Danjovic/VGA_Blinken/Readme.md

# VGA Blinking Lights
This project consists of a a device capable of generating a (pseudo) random blinking lights pattern. The objective of this project is to turn old monitors, specially CRTs, into decorative objects.
