Danjovic/VGA_Blinken/circuit/VGA Blinken.brd

## EAGLE design circuit/VGA Blinken.brd (2015-11-25)

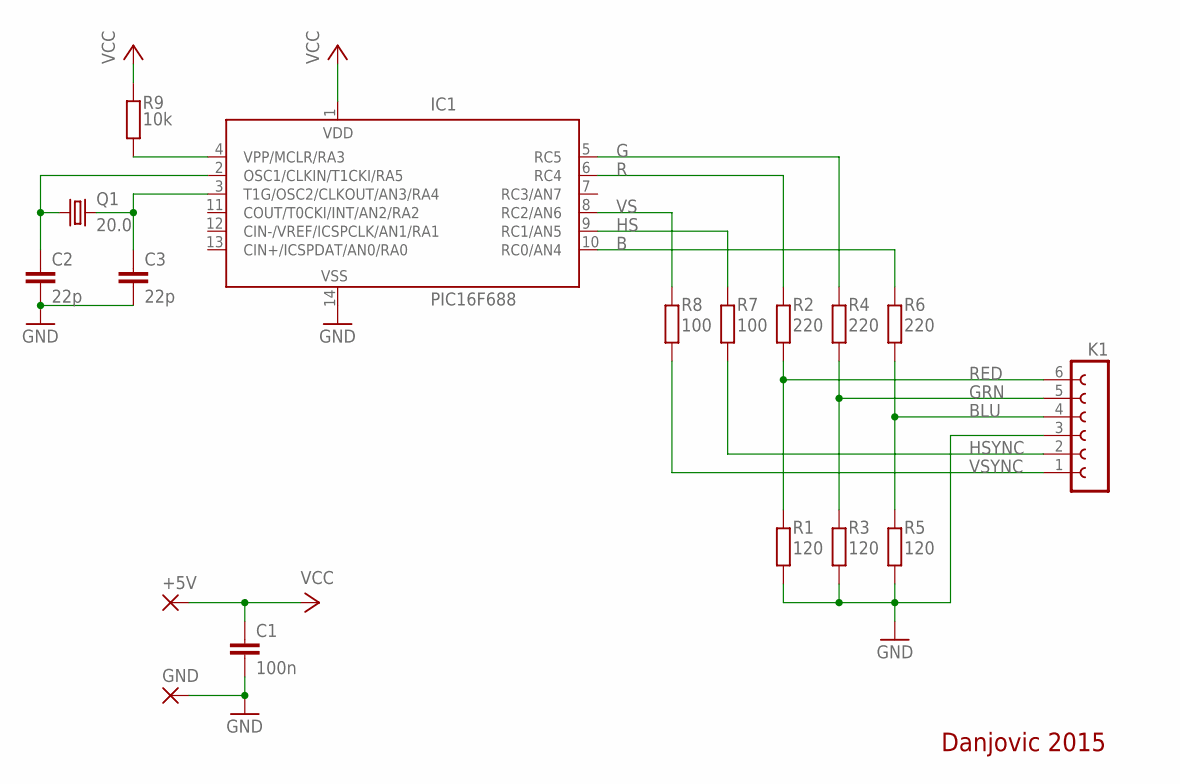
[picture p1: schematic VGA Blinken.sch]

Parts:
+5V: 1,6/0,8
C1: 100n; C025-024X044L
C2, C3: 22p; C025-024X044L
GND: 1,6/0,8
IC1: PIC16F688; DIL14
K1: FE06-1; FE06
Q1: 20.0; HC49/S
R1, R3, R5: 120; 0204VL
R2, R4, R6: 220; 0204VL
R7, R8: 100; 0204VL
R9: 10k; 0204VL

Connections:
B: IC1.10 (RC0/AN4), R6.2
BLU: K1.4, R5.1, R6.1
G: IC1.5 (RC5), R4.2
GND: C1.2, C2.2, C3.2, GND.1, IC1.14 (VSS), K1.3, R1.2, R3.2, R5.2
GRN: K1.5, R3.1, R4.1
HS: IC1.9 (RC1/AN5), R7.2
HSYNC: K1.2, R7.1
R: IC1.6 (RC4), R2.2
RED: K1.6, R1.1, R2.1
RST: IC1.4 (VPP/MCLR/RA3), R9.2
VCC: +5V.1, C1.1, IC1.1 (VDD), R9.1
VS: IC1.8 (RC2/AN6), R8.2
VSYNC: K1.1, R8.1
X1: C2.1, IC1.2 (OSC1/CLKIN/T1CKI/RA5), Q1.1
X2: C3.1, IC1.3 (T1G/OSC2/CLKOUT/AN3/RA4), Q1.2

Notes on the sheet:
Danjovic 2015

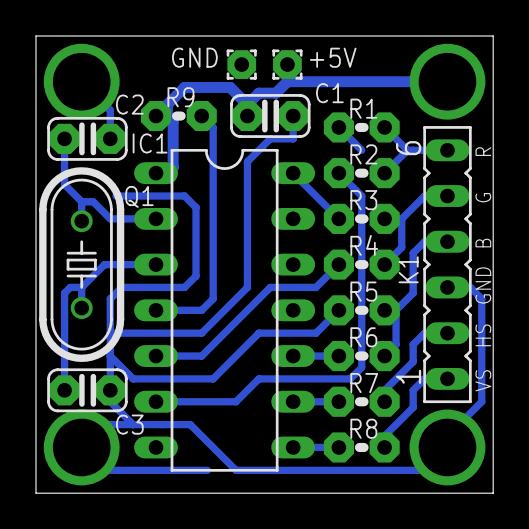
[picture p2: board VGA Blinken.brd from above]

Board: 2 copper layers, 25.4 x 25.4 mm, 17 parts (0 on the bottom side), 15 nets.
