Danjovic/VGA_Blinken/(commit log)

2015-11-25 Basic Release
    Basic release. The firmware can generate a VGA color bar pattern. This
    is the baseline for the rest of the project.
    [VGA Blinken.brd, VGA Blinken.sch]
2015-11-25 PCB files moved to its own folder
    [VGA Blinken.brd, VGA Blinken.sch]
2015-11-28 Added Gerber Files
